htarold/free_ranger/range_demo_front.jpg

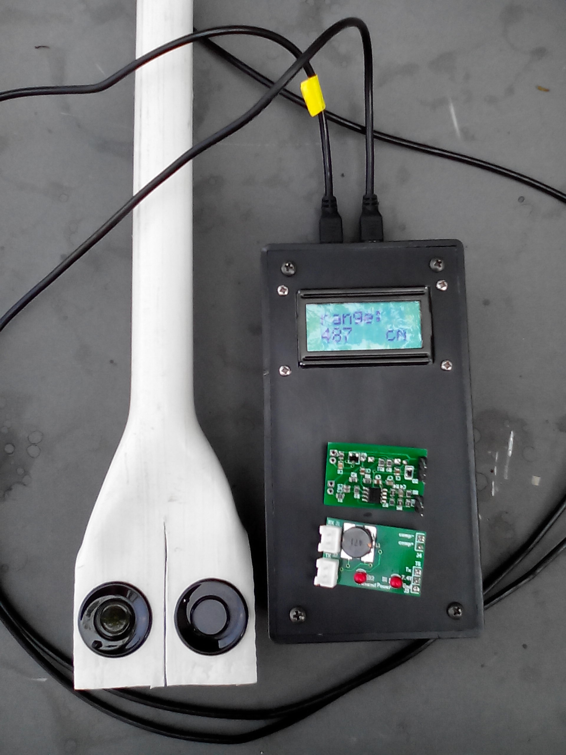
range_demo_front.jpg
