htarold/free_ranger/range_demo_guts.jpg

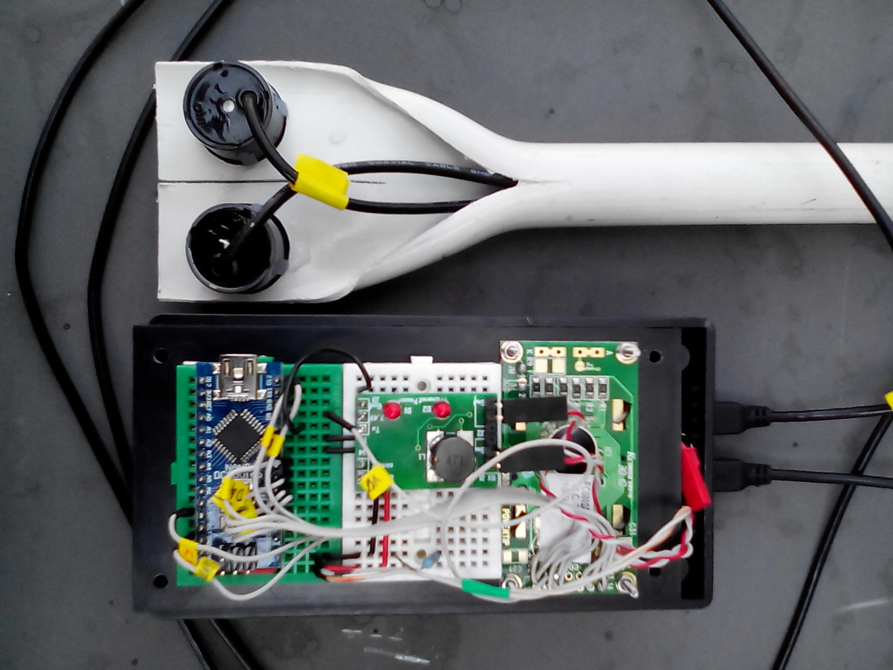
range_demo_guts.jpg
