htarold/free_ranger/trace-in-air.bmp

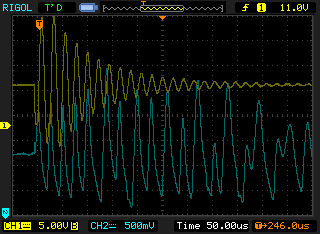
trace-in-air.bmp
