htarold/free_ranger/trace-no-transducers.bmp

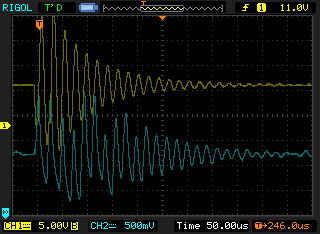
trace-no-transducers.bmp
