htarold/free_ranger/trace-tank-length.bmp

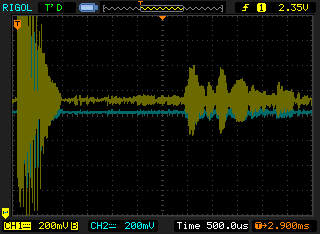
trace-tank-length.bmp
