htarold/free_ranger/free_ranger.sch.pdf

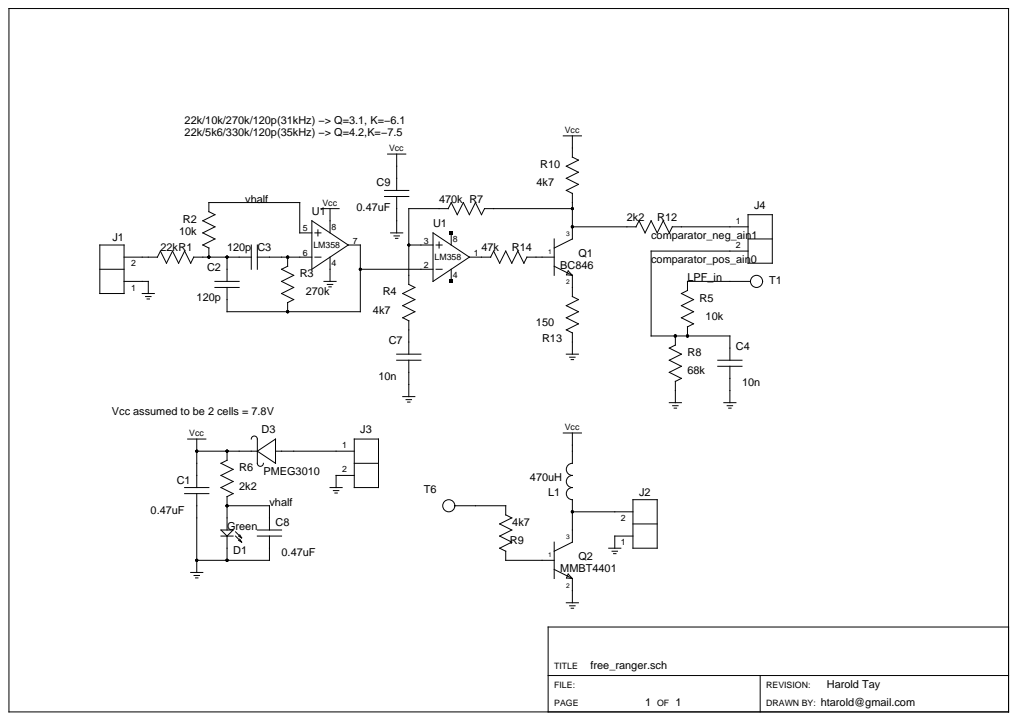
[picture p6: page 1]

Vcc assumed to be 2 cells = 7.8V
