htarold/free_ranger/(list of files, drawings)

Other design files:
free_ranger.pcb
