htarold/free_ranger/(commit log)

2015-04-27 Initial commit.
    [free_ranger.pcb, free_ranger.sch]
2015-05-03 New file, needs cleanup. free_ranger.c will be removed later, this replaces it.
    [range_demo.ino]
2015-05-03 Fixed hidden refdes on overlay. Reduced drilling size for XH.
    [free_ranger.pcb]
2015-05-09 Replaced by arduino demo code.
2015-05-09 Replaces C code. Uses Timer 0 instead of timed loop for timing.
    [range_demo.ino]
2015-05-09 Sample scope traces.
2015-05-09 Removed old arduino code.
2015-05-09 Doubled gain in gain stage, 10k -> 4k7 resistor.
    [free_ranger.sch]
2015-05-09 BOM update (10k->4k7).
    [free_ranger.pcb]
2015-05-16 Changed 220k to 270k for reduced output offset. Use in pool requires better sensitivity than in small tank.
    [free_ranger.sch]
2015-05-23 Added annotations for other Q/K filter options.
    [free_ranger.sch]
2015-05-23 Changed power back to 12 from 6us.
2015-06-06 Going to remove comparator. Either use on-board comparator, or if using multiple receivers, then use a separate DIP comparator, which will be easy to integrate on a breadboard.
    Also only exporting the analogue signal. The comparator will
    need to derive its own threshold.
    [free_ranger.pcb, free_ranger.sch]
2015-06-11 Removed comparator. Next: Use high voltage transistor (requires more drive); Restore other signal input for external comparator.
    [free_ranger.pcb, free_ranger.sch]
2015-07-05 Transmit circuit cannot use high-voltage transistor, stay with 4401. LPF made optional through jumper.
    [free_ranger.pcb, free_ranger.sch]
2015-08-07 Update gerbers.
